miguelfercos/Wemos_design/New_Project/Practica1.v2.brd

## EAGLE design New_Project/Practica1.v2.brd (2023-06-08)

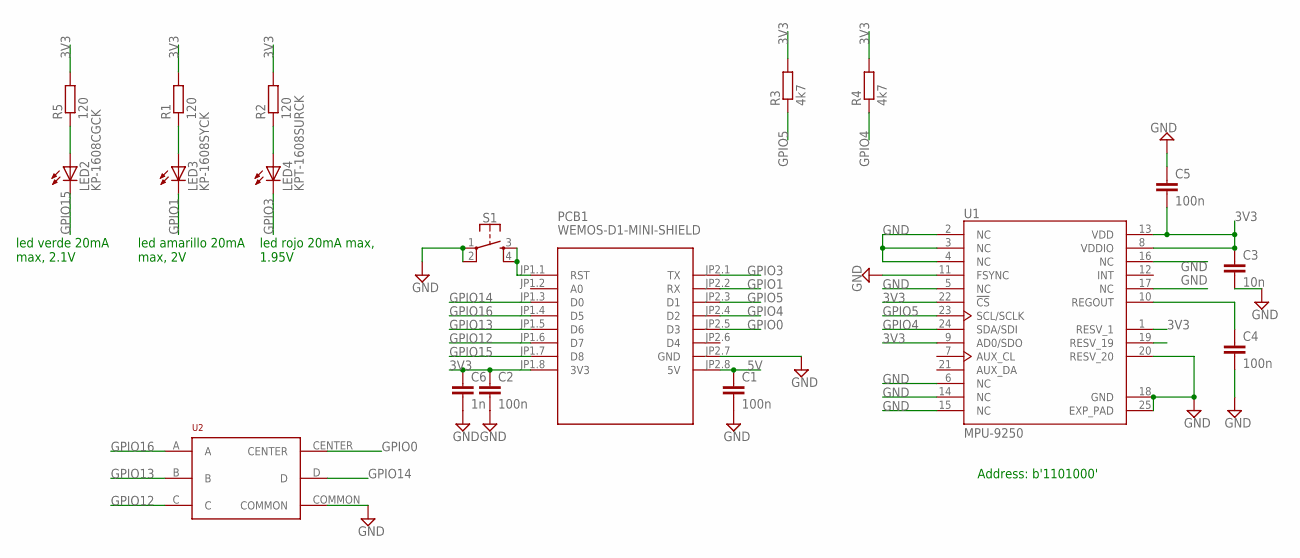
[picture p2: schematic Practica1.v2.sch]

Parts:
C1, C2, C4, C5: 100n; C0805
C3: 10n; C0603
C6: 1n; C0402
LED2: KP-1608CGCK; LED_SML0603
LED3: KP-1608SYCK; LED_SML0603
LED4: KPT-1608SURCK; LED_SML0603
PCB1: WEMOS-D1-MINI-SHIELD
R1, R2, R5: 120; R1206
R3, R4: 4k7; R1206
S1: MOMENTARY-SWITCH-SPST-2-SMD-5.2MM-TALL; TACTILE_SWITCH_SMD_5.2MM
U1: MPU-9250; QFN40P300X300X105-25N
U2: JOYSTICK; JOYSTICK_516_316

Connections:
3V3: C2.1, C3.1, C5.2, C6.1, PCB1.JP1.8 (3V3), R1.2, R2.2, R3.2, R4.2, R5.2, U1.1 (RESV_1), U1.8 (VDDIO), U1.9 (AD0/SDO), U1.13 (VDD), U1.22 (!CS)
5V: C1.1, PCB1.JP2.8 (5V)
FEGDC: LED2.A, R5.1
GND: C1.2, C2.2, C3.2, C4.2, C5.1, C6.2, PCB1.JP2.7 (GND), S1.1, S1.2, U1.2 (NC), U1.3 (NC), U1.4 (NC), U1.5 (NC), U1.6 (NC), U1.11 (FSYNC), U1.14 (NC), U1.15 (NC), U1.16 (NC), U1.17 (NC), U1.18 (GND), U1.20 (RESV_20), U1.25 (EXP_PAD), U2.COMMON
GPIO0: PCB1.JP2.5 (D3), U2.CENTER
GPIO1: LED3.C, PCB1.JP2.2 (RX)
GPIO3: LED4.C, PCB1.JP2.1 (TX)
GPIO4: PCB1.JP2.4 (D2), R4.1, U1.24 (SDA/SDI)
GPIO5: PCB1.JP2.3 (D1), R3.1, U1.23 (SCL/SCLK)
GPIO12: PCB1.JP1.6 (D7), U2.C
GPIO13: PCB1.JP1.5 (D6), U2.B
GPIO14: PCB1.JP1.3 (D0), U2.D
GPIO15: LED2.C, PCB1.JP1.7 (D8)
GPIO16: PCB1.JP1.4 (D5), U2.A
unnamed: PCB1.JP1.1 (RST), S1.3, S1.4
unnamed: LED3.A, R1.1
unnamed: LED4.A, R2.1
unnamed: C4.1, U1.10 (REGOUT)

Notes on the sheet:
led verde 20mA max, 2.1V
led amarillo 20mA max, 2V
led rojo 20mA max, 1.95V
Address: b'1101000'

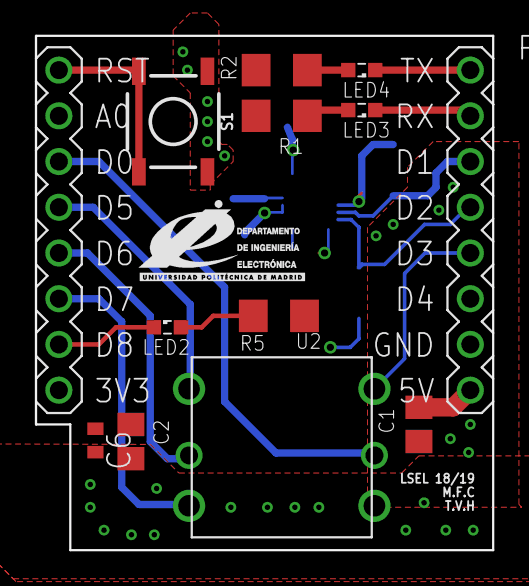
[picture p3: board Practica1.v2.brd from above]

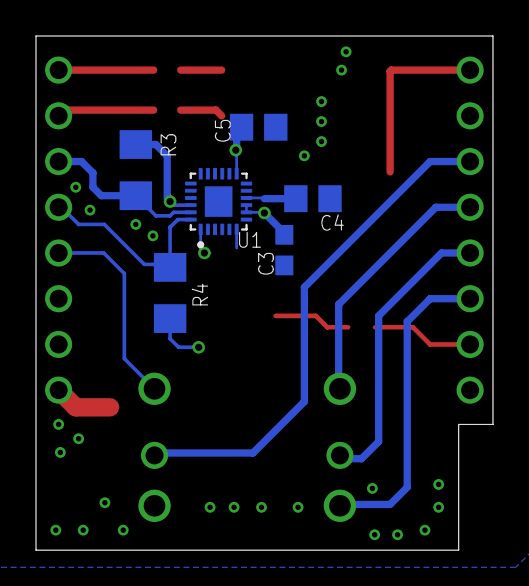
[picture p4: board Practica1.v2.brd from below]

Board: 2 copper layers, 25.4 x 28.6 mm, 19 parts (6 on the bottom side), 18 nets.

Other parts of the board:
U$1: DIE_UPM
